vit-ka/esp32-110v-pressure-sensor/components/IRM-05-24.pdf

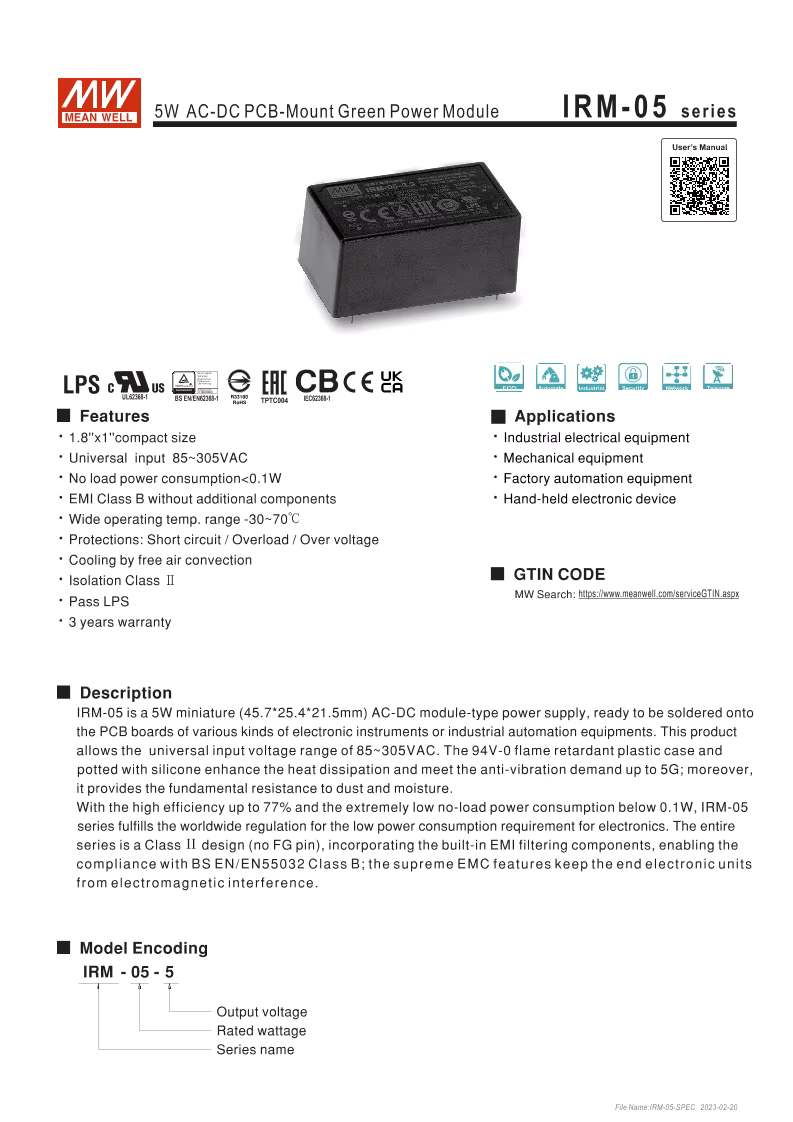
[picture p1: page 1]
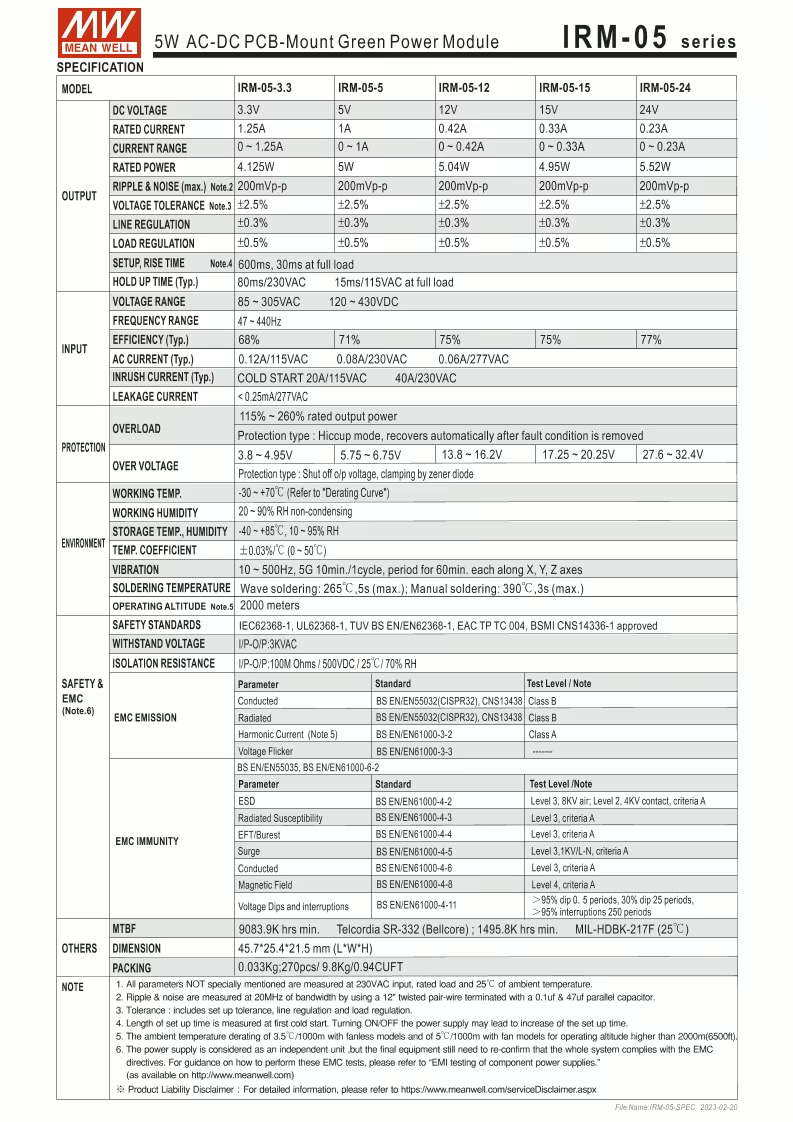
[picture p2: page 2]
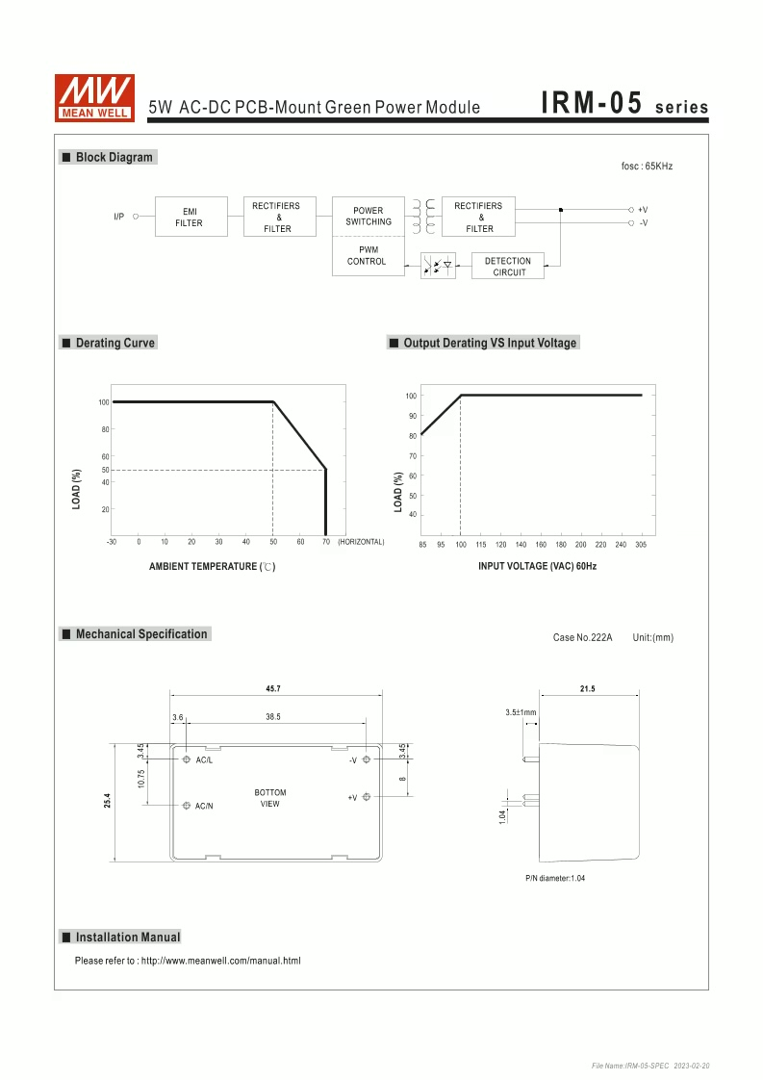
[picture p3: page 3]
