vit-ka/esp32-110v-pressure-sensor/(list of files, drawings)

Other design files:
ProPrj_esp32_pressure_sensor_2026-01-26.epro
