vit-ka/esp32-110v-pressure-sensor/(commit log)

2026-01-26 Add project documentation and ESPHome config
    - README.md with BOM, pinout, wiring, and setup instructions
    - ESPHome example config with secrets separated out
    - Probe template with ADC smoothing and voltage-to-PSI calibration
    - Document known PCB issue (ADC2/WiFi conflict on GPIO5)
2026-01-26 Update secret names to be pressure-probe specific
    Renamed secrets for better organization when sharing secrets.yaml
    across multiple ESPHome projects:
    - api_encryption_key -> pressure_probe_encryption_key
    - ota_password -> pressure_probe_ota_password
    - ap_password -> pressure_probe_wifi_ap_password
2026-01-26 Updated issues in the cad file
    [ProPrj_esp32_pressure_sensor_2026-01-10.epro, ProPrj_esp32_pressure_sensor_2026-01-26.epro]
2026-01-26 Fix PCB GPIO routing and update documentation
    - Updated PCB to route SIG1->GPIO1, SIG2->GPIO3 (ADC1 pins)
    - Removed warnings about ADC2/WiFi conflict
    - Simplified pinout table now that PCB matches config
2026-01-26 Add detailed calibration instructions
    - Recommend IRONWALLS hydrostatic pressure tester (G1/4 compatible)
    - Step-by-step calibration process using ESPHome logs
2026-01-26 Add calibration config for raw voltage readings
    - calibration-config.yaml outputs raw ADC voltage every 1s
    - Updated README with calibration workflow
    [calibration-config.yaml]
2026-01-26 Simplify calibration config to single probe
    Same calibration table is used for both probes, so only need one.
    [calibration-config.yaml]
2026-01-31 Calibrated voltage for real probe
2026-01-31 Add shared calibration tables header with lookup function
2026-01-31 Use shared calibration table lookup in pressure probe template
2026-01-31 Add calibration probe template with raw voltage, moving average, and PSI
    [calibration_pressure_probe.yaml]
2026-01-31 Wire up calibration table IDs in example device config
2026-01-31 Add calibration device config with PSI output
    [calibration-with-psi.yaml]
2026-01-31 more calibration
    [calibration_pressure_probe.yaml]
2026-01-31 better print
    [calibration-with-psi.yaml]
2026-01-31 Better avg in calibration
    [calibration_pressure_probe.yaml]
2026-01-31 better 24v table
2026-01-31 rename of probes
    [calibration-with-psi.yaml]
2026-01-31 more linear calibration table
2026-01-31 linearity correction for another calibration table too
2026-02-01 Added 110 and 120 psi to 0.8MPa sensor
2026-02-01 Added 100-150 psi for 1MPa sensor
2026-07-24 Add calibrated 0.5-5V 0-1MPa probe table
    Linearized from measured calibration (11.4 mV/psi), 110-150 psi extrapolated.
